Xasin/TapBadgeV2/KiCAD/ModelRef.jpg

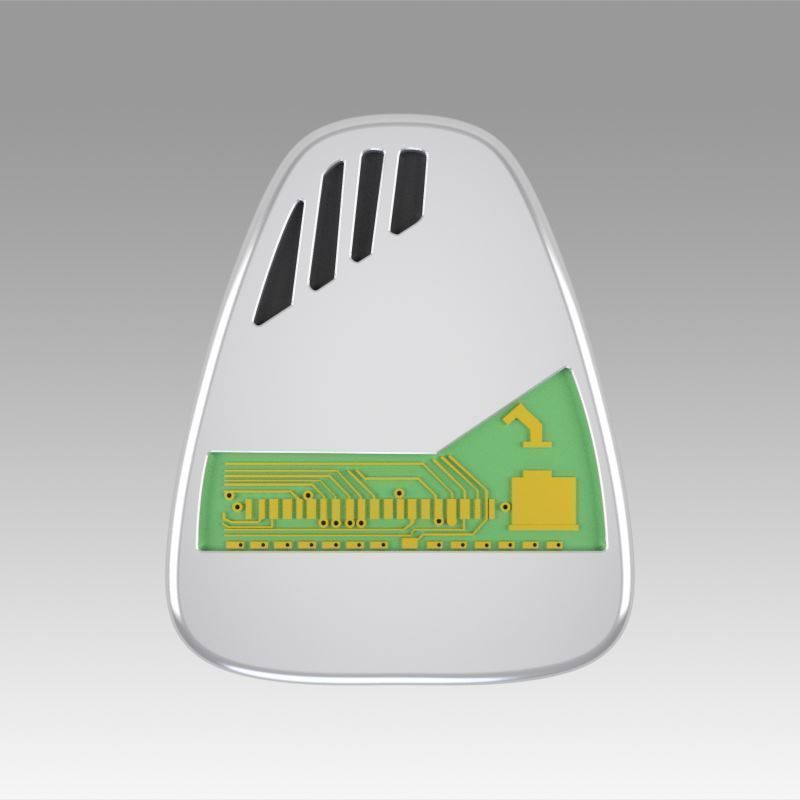
KiCAD/ModelRef.jpg
