Xasin/TapBadgeV2/README.md

# TapBadgeV2
The second, far more ambitious version of the TapBadge wearable
