Xasin/TapBadgeV2/KiCAD/LSM6DSMTR--3DModel-STEP-56544.STEP

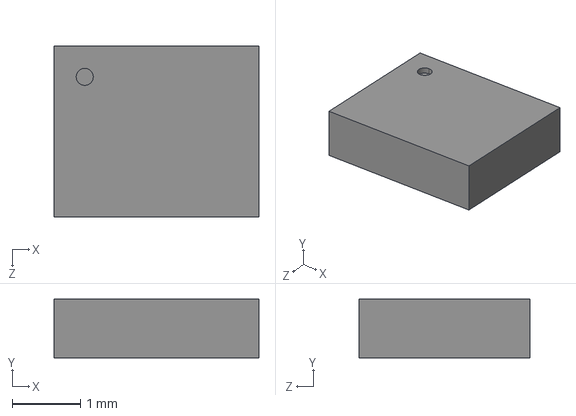
[picture p2: CAD file, 2021-07-29]
KiCAD/LSM6DSMTR--3DModel-STEP-56544.STEP
3.00 x 0.86 x 2.50 mm
