Xasin/TapBadgeV2/KiCAD/TMP/TapBadgeV2-B.Cu.dxf

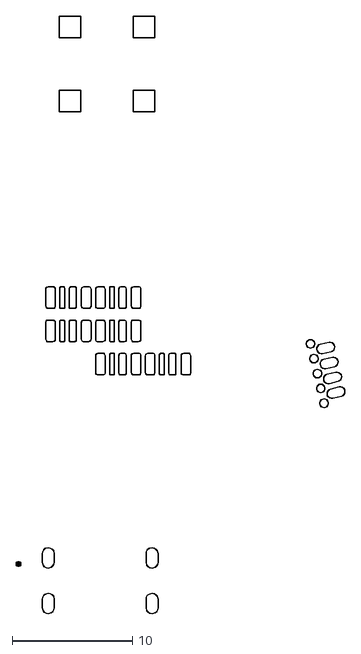
[picture p3: CAD file, 2021-07-29]
KiCAD/TMP/TapBadgeV2-B.Cu.dxf
27.4 x 49.8
