Xasin/TapBadgeV2/KiCAD/TapRef.FCStd

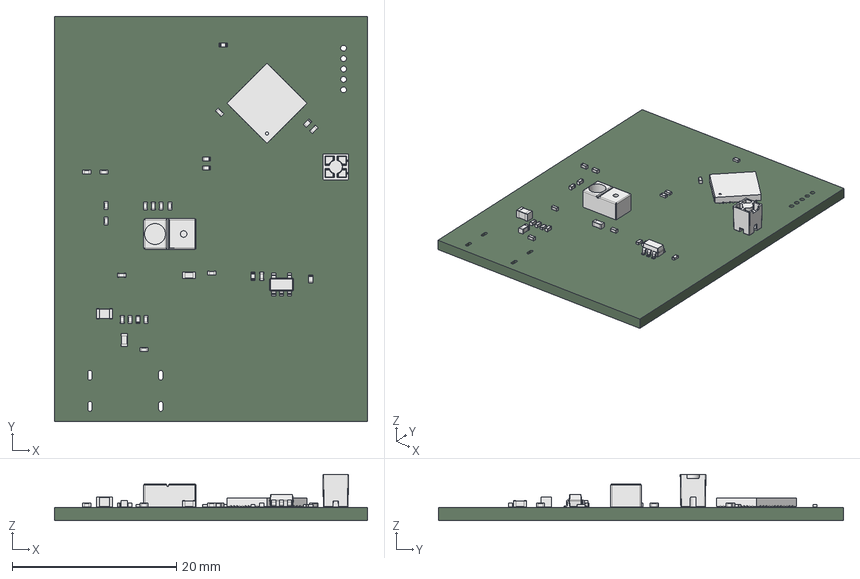
[picture p4: CAD file, 2021-07-29]
KiCAD/TapRef.FCStd
38.2 x 49.4 x 5.65 mm
