Xasin/TapBadgeV2/KiCAD/TMP/TapBadgeV2-Edge.Cuts.dxf

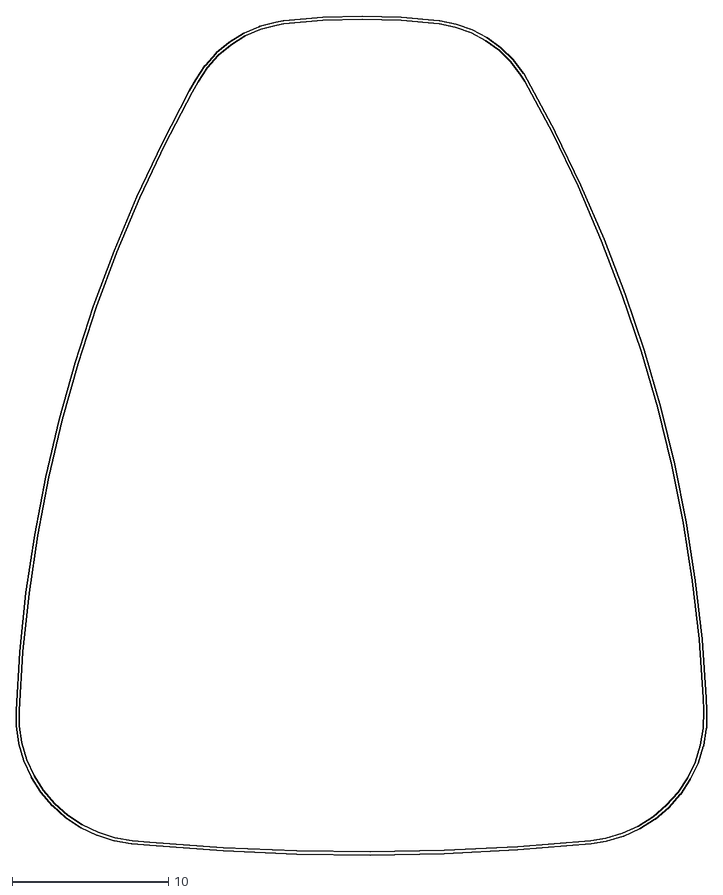
[picture p5: CAD file, 2021-07-29]
KiCAD/TMP/TapBadgeV2-Edge.Cuts.dxf
44.2 x 53.7
