Xasin/TapBadgeV2/KiCAD/TMP/TapBadgeV2-In1.Cu.dxf

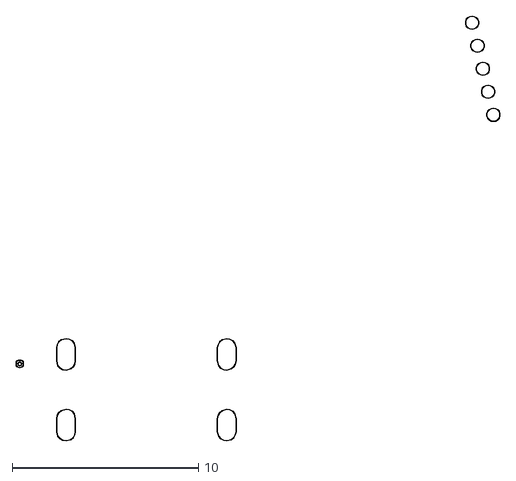
[picture p6: CAD file, 2021-07-29]
KiCAD/TMP/TapBadgeV2-In1.Cu.dxf
26.0 x 22.8
