Xasin/TapBadgeV2/KiCAD/TMP/TapBadgeV2-F.Cu.dxf

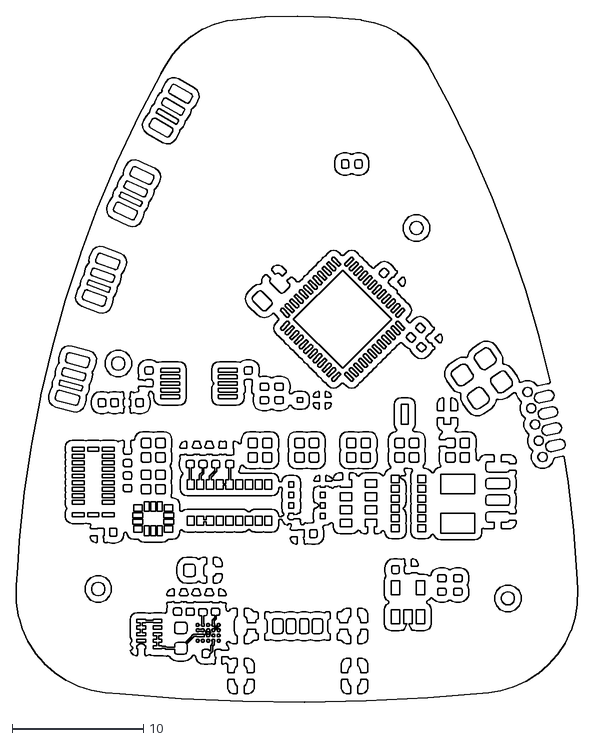
[picture p7: CAD file, 2021-07-29]
KiCAD/TMP/TapBadgeV2-F.Cu.dxf
42.8 x 52.2
