Xasin/TapBadgeV2/(list of files, cad)

Other CAD files:
KiCAD/TMP/TapBadgeV2-B.Mask.dxf
KiCAD/TMP/TapBadgeV2-B.Paste.dxf
KiCAD/TMP/TapBadgeV2-B.SilkS.dxf
KiCAD/TMP/TapBadgeV2-F.Mask.dxf
KiCAD/TMP/TapBadgeV2-F.Paste.dxf
KiCAD/TMP/TapBadgeV2-F.SilkS.dxf
KiCAD/TapRef.dxf
