Xasin/TapBadgeV2/KiCAD/TapBadgeV2.kicad_pcb

## KiCad design KiCAD/TapBadgeV2.kicad_pcb (2021-10-18)

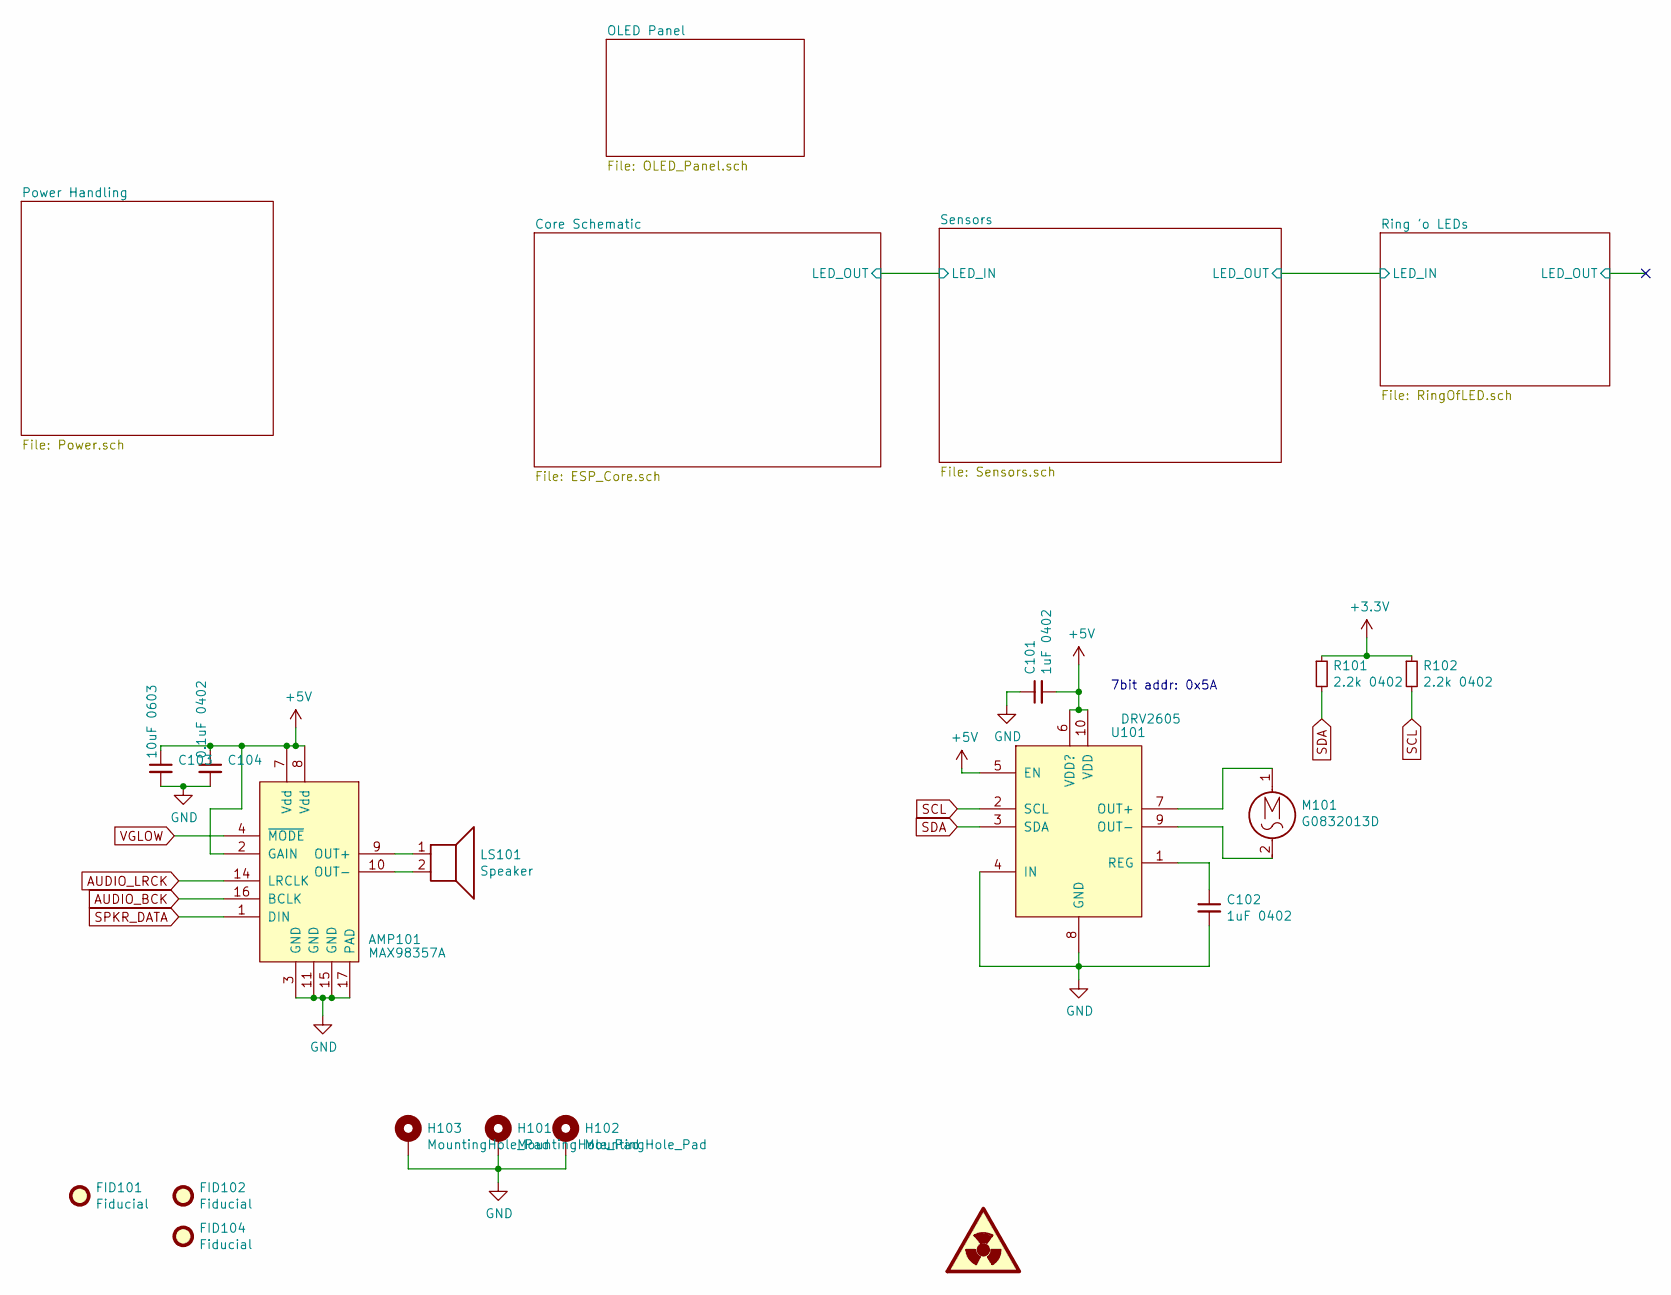
[picture p8: schematic TapBadgeV2.sch]

Parts:
AMP101: MAX98357A; QFN-16-1EP_3x3mm_P0.5mm_EP1.9x1.9mm_ThermalVias
C101, C102: 1uF 0402; C_0402_1005Metric
C103: 10uF 0603; C_0603_1608Metric
C104: 0.1uF 0402; C_0402_1005Metric
FID101, FID102, FID104: Fiducial; Fiducial_1mm_Mask2mm
H101, H102, H103: MountingHole_Pad; MountingHole_1.5mm_M1_Pad_Via
LS101: Speaker; SP-1609S-1
M101: G0832013D; PinHeader_1x02_P2.00mm_Vertical
R101, R102: 2.2k 0402; R_0402_1005Metric
SYM101: SYM_Radioactive_Large; DragonIcon_7mm_Solder
U101: DRV2605; VSSOP-10_3x3mm_P0.5mm

Connections:
+3V3: R101.1, R102.1; also elsewhere on the board
+5V: AMP101.2 (GAIN), AMP101.7 (Vdd), AMP101.8 (Vdd), C101.2, C103.1, C104.1, U101.5 (EN), U101.6 (VDD?), U101.10 (VDD); also elsewhere on the board
AUDIO_BCK: AMP101.16 (BCLK); also elsewhere on the board
AUDIO_LRCK: AMP101.14 (LRCLK); also elsewhere on the board
GND: AMP101.3 (GND), AMP101.11 (GND), AMP101.15 (GND), AMP101.17 (PAD), C101.1, C102.2, C103.2, C104.2, H101.1, H102.1, H103.1, U101.4 (IN), U101.8 (GND); also elsewhere on the board
unnamed: AMP101.9 (OUT+), LS101.1
unnamed: AMP101.10 (OUT-), LS101.2
unnamed: C102.1, U101.1 (REG)
unnamed: M101.1, U101.7 (OUT+)
unnamed: M101.2, U101.9 (OUT-)
SCL: R102.2, U101.2 (SCL); also elsewhere on the board
SDA: R101.2, U101.3 (SDA); also elsewhere on the board
SPKR_DATA: AMP101.1 (DIN); also elsewhere on the board
VGLOW: AMP101.4 (~MODE); also elsewhere on the board

Notes on the sheet:
7bit addr: 0x5A

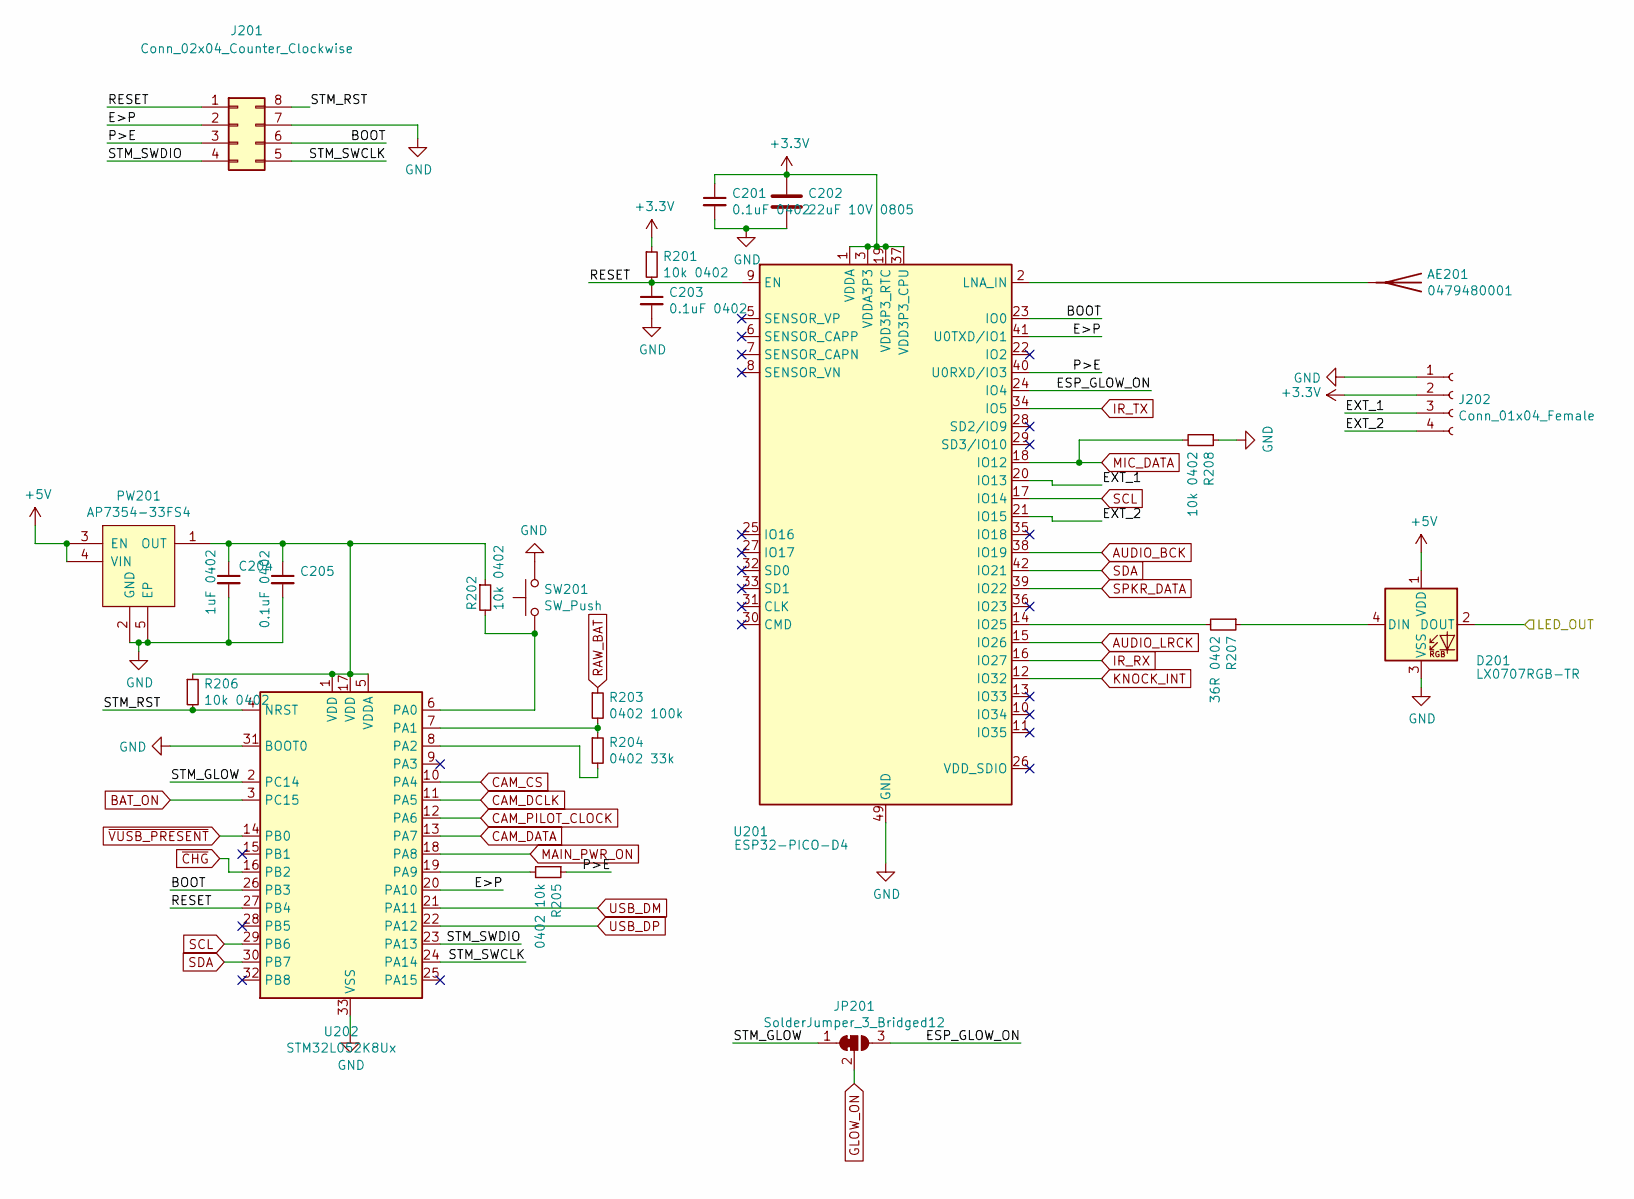
[picture p9: schematic ESP_Core.sch]

Parts:
AE201: 0479480001
C201, C203, C205: 0.1uF 0402; C_0402_1005Metric
C202: 22uF 10V 0805; C_0805_2012Metric
C204: 1uF 0402; C_0402_1005Metric
D201: LX0707RGB-TR; SMD-LX0707RGB-TR
J201: Conn_02x04_Counter_Clockwise; SOIC_clipProgSmall
J202: Conn_01x04_Female; PinHeader_1x04_P1.27mm_Vertical
JP201: SolderJumper_3_Bridged12; SolderJumper-3_P1.3mm_Open_RoundedPad1.0x1.5mm
PW201: AP7354-33FS4; X2-DFN1010-4
R201, R202, R206, R208: 10k 0402; R_0402_1005Metric
R203: 0402 100k; R_0402_1005Metric
R204: 0402 33k; R_0402_1005Metric
R205: 0402 10k; R_0402_1005Metric
R207: 36R 0402; R_0402_1005Metric
SW201: SW_Push; SW_SPST_B3U-1000P
U201: ESP32-PICO-D4; QFN-48-1EP_7x7mm_P0.5mm_EP5.3x5.3mm
U202: STM32L052K8Ux; QFN-32-1EP_5x5mm_P0.5mm_EP3.45x3.45mm

Connections:
+3V3: C201.1, C202.1, J202.2, R201.1, U201.1 (VDDA), U201.3 (VDDA3P3), U201.4 (VDDA3P3), U201.19 (VDD3P3_RTC), U201.37 (VDD3P3_CPU), U201.43 (VDDA), U201.46 (VDDA); also elsewhere on the board
+5V: D201.1 (VDD), PW201.3 (EN), PW201.4 (VIN); also elsewhere on the board
/Core Schematic/BOOT: J201.6, U201.23 (IO0), U202.26 (PB3)
/Core Schematic/E>P: J201.2, U201.41 (U0TXD/IO1), U202.20 (PA10)
/Core Schematic/ESP_GLOW_ON: JP201.3 (B), U201.24 (IO4)
/Core Schematic/EXT_1: J202.3, U201.20 (IO13)
/Core Schematic/EXT_2: J202.4, U201.21 (IO15)
/Core Schematic/P>E: J201.3, R205.1, U201.40 (U0RXD/IO3)
/Core Schematic/RESET: C203.1, J201.1, R201.2, U201.9 (EN), U202.27 (PB4)
/Core Schematic/STM_GLOW: JP201.1 (A), U202.2 (PC14)
/Core Schematic/STM_RST: J201.8, R206.2, U202.4 (NRST)
/Core Schematic/STM_SWCLK: J201.5, U202.24 (PA14)
/Core Schematic/STM_SWDIO: J201.4, U202.23 (PA13)
/Sensors/LED_IN: D201.2 (DOUT); also elsewhere on the board
AUDIO_BCK: U201.38 (IO19); also elsewhere on the board
AUDIO_LRCK: U201.15 (IO26); also elsewhere on the board
BAT_ON: U202.3 (PC15); also elsewhere on the board
CAM_CS: U202.10 (PA4); also elsewhere on the board
CAM_DATA: U202.13 (PA7); also elsewhere on the board
CAM_DCLK: U202.11 (PA5); also elsewhere on the board
CAM_PILOT_CLOCK: U202.12 (PA6); also elsewhere on the board
GLOW_ON: JP201.2 (C); also elsewhere on the board
GND: C201.2, C202.2, C203.2, C204.2, C205.2, D201.3 (VSS), J201.7, J202.1, PW201.2 (GND), PW201.5 (EP), R208.1, SW201.2, U201.49 (GND), U202.31 (BOOT0), U202.33 (VSS); also elsewhere on the board
IR_RX: U201.16 (IO27); also elsewhere on the board
IR_TX: U201.34 (IO5); also elsewhere on the board
KNOCK_INT: U201.12 (IO32); also elsewhere on the board
MAIN_PWR_ON: U202.18 (PA8); also elsewhere on the board
MIC_DATA: R208.2, U201.18 (IO12); also elsewhere on the board
unnamed: AE201.1, U201.2 (LNA_IN)
unnamed: C204.1, C205.1, PW201.1 (OUT), R202.1, R206.1, U202.1 (VDD), U202.5 (VDDA), U202.17 (VDD)
unnamed: D201.4 (DIN), R207.1
unnamed: R202.2, SW201.1, U202.6 (PA0)
unnamed: R203.2, R204.1, U202.7 (PA1)
unnamed: R204.2, U202.8 (PA2)
unnamed: R205.2, U202.19 (PA9)
unnamed: R207.2, U201.14 (IO25)
RAW_BAT: R203.1; also elsewhere on the board
SCL: U201.17 (IO14), U202.29 (PB6); also elsewhere on the board
SDA: U201.42 (IO21), U202.30 (PB7); also elsewhere on the board
SPKR_DATA: U201.39 (IO22); also elsewhere on the board
USB_DM: U202.21 (PA11); also elsewhere on the board
USB_DP: U202.22 (PA12); also elsewhere on the board
~CHG: U202.16 (PB2); also elsewhere on the board
~VUSB_PRESENT: U202.14 (PB0); also elsewhere on the board

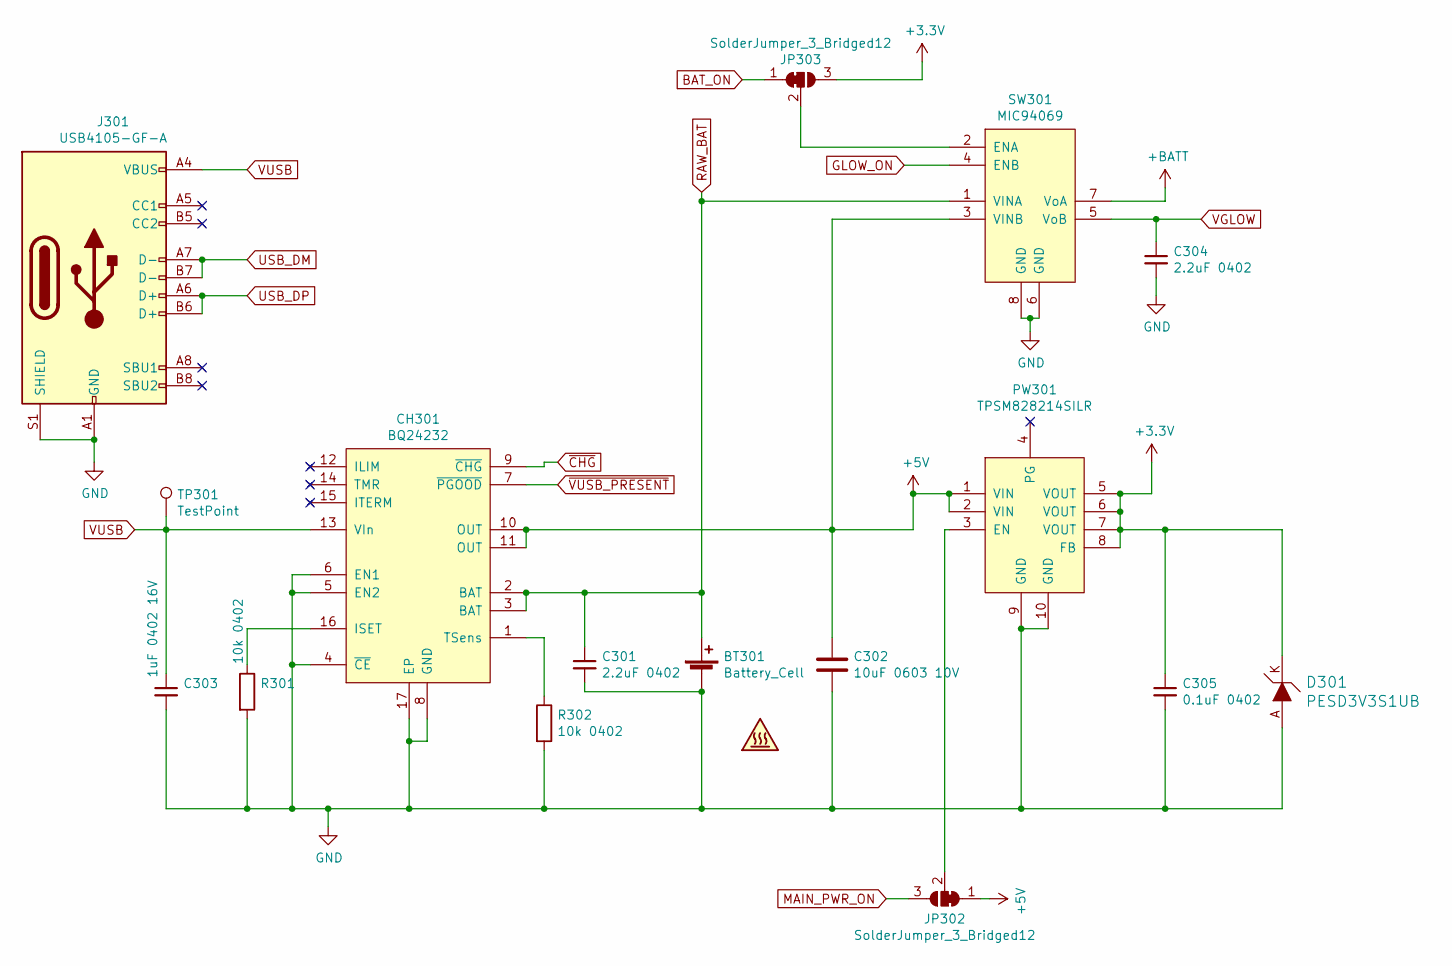
[picture p10: schematic Power.sch]

Parts:
BAT301: SYM_Hot_Small; LiPo_150mAh
BT301: Battery_Cell; JST_PH_S2B-PH-SM4-TB_1x02-1MP_P2.00mm_Horizontal
C301, C304: 2.2uF 0402; C_0402_1005Metric
C302: 10uF 0603 10V; C_0603_1608Metric
C303: 1uF 0402 16V; C_0402_1005Metric
C305: 0.1uF 0402; C_0402_1005Metric
CH301: BQ24232; VQFN-16-1EP_3x3mm_P0.5mm_EP1.6x1.6mm_ThermalVias
D301: PESD3V3S1UB; SOD-523; MPN ESD5Z3.3T1G; Digi-Key_PN ESD5Z3.3T1GOSCT-ND
J301: USB4105-GF-A; USB_C_Receptacle_HRO_TYPE-C-31-M-12
JP302, JP303: SolderJumper_3_Bridged12; SolderJumper-3_P1.3mm_Open_RoundedPad1.0x1.5mm
PW301: TPSM828214SILR; uSIP-10
R301, R302: 10k 0402; R_0402_1005Metric
SW301: MIC94069; MLF-6-EP-P0.5mm
TP301: TestPoint; PinHeader_1x01_P1.27mm_Vertical

Connections:
+3V3: C305.1, D301.K, JP303.3 (B), PW301.5 (VOUT), PW301.6 (VOUT), PW301.7 (VOUT), PW301.8 (FB); also elsewhere on the board
+5V: C302.1, CH301.10 (OUT), CH301.11 (OUT), JP302.1 (A), PW301.1 (VIN), PW301.2 (VIN), SW301.3 (VINB); also elsewhere on the board
+BATT: SW301.7 (VoA); also elsewhere on the board
BAT_ON: JP303.1 (A); also elsewhere on the board
GLOW_ON: SW301.4 (ENB); also elsewhere on the board
GND: BT301.2 (-), C301.2, C302.2, C303.2, C304.2, C305.2, CH301.4 (~CE), CH301.5 (EN2), CH301.6 (EN1), CH301.8 (GND), CH301.17 (EP), D301.A, J301.A1 (GND), J301.A12 (GND), J301.B1 (GND), J301.B12 (GND), J301.S1 (SHIELD), PW301.9 (GND), PW301.10 (GND), R301.2, R302.2, SW301.6 (GND), SW301.8 (GND); also elsewhere on the board
MAIN_PWR_ON: JP302.3 (B); also elsewhere on the board
unnamed: CH301.1 (TSens), R302.1
unnamed: CH301.16 (ISET), R301.1
unnamed: JP302.2 (C), PW301.3 (EN)
unnamed: JP303.2 (C), SW301.2 (ENA)
RAW_BAT: BT301.1 (+), C301.1, CH301.2 (BAT), CH301.3 (BAT), SW301.1 (VINA); also elsewhere on the board
USB_DM: J301.A7 (D-), J301.B7 (D-); also elsewhere on the board
USB_DP: J301.A6 (D+), J301.B6 (D+); also elsewhere on the board
VGLOW: C304.1, SW301.5 (VoB); also elsewhere on the board
VUSB: C303.1, CH301.13 (VIn), J301.A4 (VBUS), J301.A9 (VBUS), J301.B4 (VBUS), J301.B9 (VBUS), TP301.1
~CHG: CH301.9 (~CHG); also elsewhere on the board
~VUSB_PRESENT: CH301.7 (~PGOOD); also elsewhere on the board

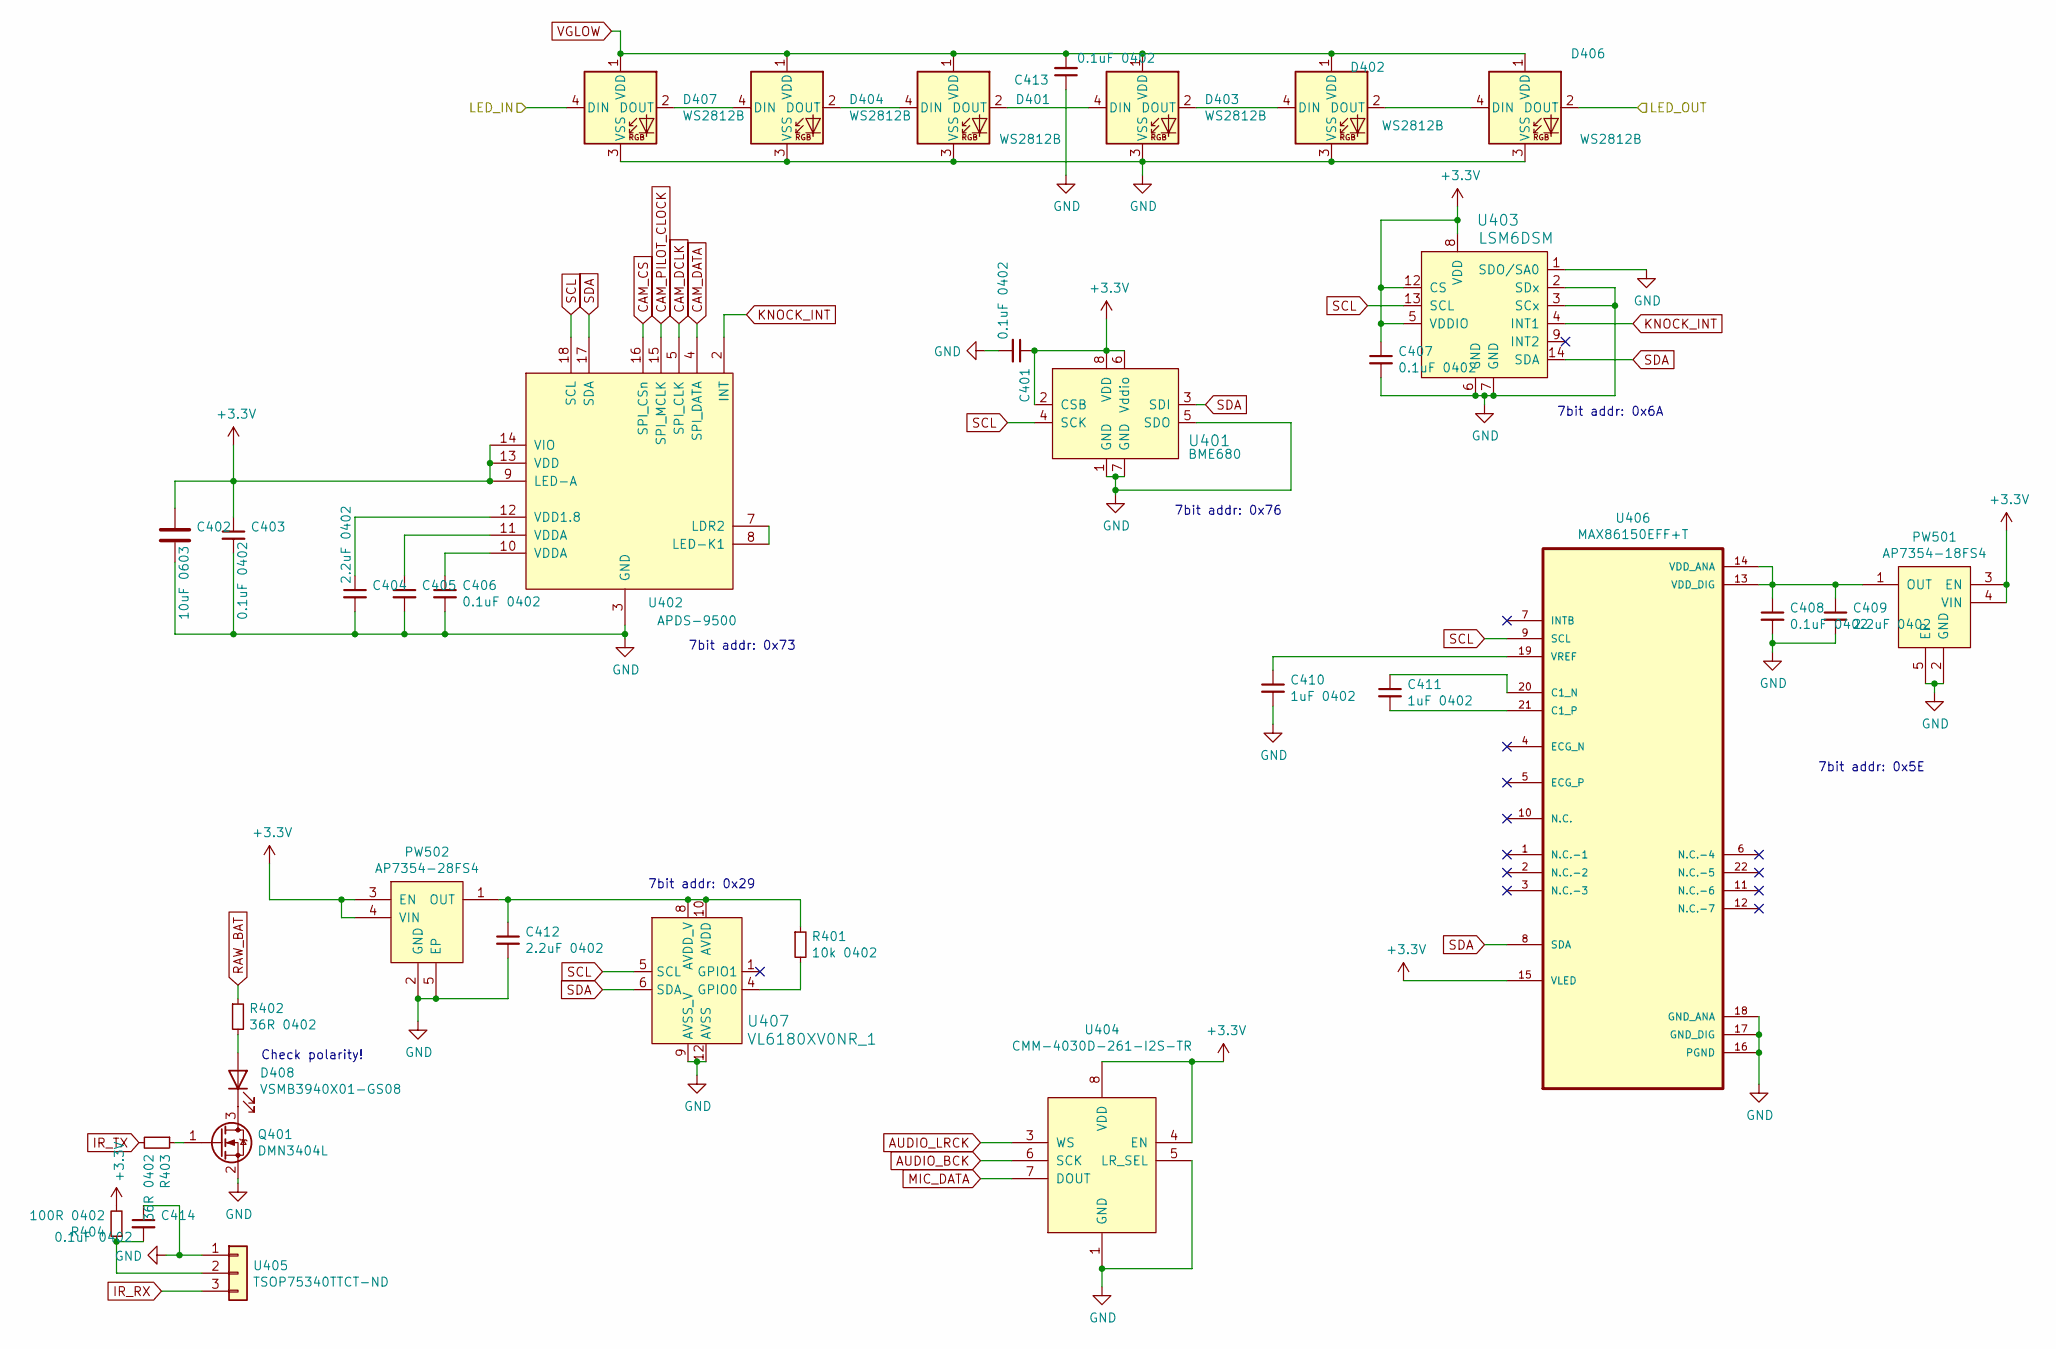
[picture p11: schematic Sensors.sch]

Parts:
C401, C403, C405, C406, C407, C408, C413, C414: 0.1uF 0402; C_0402_1005Metric
C402: 10uF 0603; C_0603_1608Metric
C404, C409, C412: 2.2uF 0402; C_0402_1005Metric
C410, C411: 1uF 0402; C_0402_1005Metric
D401, D402, D403, D404, D406, D407: WS2812B; SMD-LX0707RGB-TR
D408: VSMB3940X01-GS08; LED_PLCC-2
PW501: AP7354-18FS4; X2-DFN1010-4
PW502: AP7354-28FS4; X2-DFN1010-4
Q401: DMN3404L; SOT-23
R401: 10k 0402; R_0402_1005Metric
R402, R403: 36R 0402; R_0402_1005Metric
R404: 100R 0402; R_0402_1005Metric
U401: BME680; MPN BME680; Digi-Key_PN 828-1077-1-ND
U402: APDS-9500
U403: LSM6DSM; LGA-14L_2.5x3mm__LSM6DS3; MPN LSM6DS3TR; Digi-Key_PN 497-15383-1-ND
U404: CMM-4030D-261-I2S-TR; CMM-4030
U405: TSOP75340TTCT-ND; TSOP75xxx
U406: MAX86150EFF+T; XDCR_MAX86150EFF+
U407: VL6180XV0NR_1; LGA-12_4.8x2.8_VL6180; MPN VL6180XV0NR/1; Digi-Key_PN 497-14702-1-ND

Connections:
+3V3: C401.1, C402.1, C403.1, C407.1, PW501.3 (EN), PW501.4 (VIN), PW502.3 (EN), PW502.4 (VIN), R404.2, U401.2 (CSB), U401.6 (Vddio), U401.8 (VDD), U402.9 (LED-A), U402.13 (VDD), U402.14 (VIO), U403.5 (VDDIO), U403.8 (VDD), U403.12 (CS), U404.4 (EN), U404.8 (VDD), U406.15 (VLED); also elsewhere on the board
/Ring 'o LEDs/LED_IN: D406.2 (DOUT); also elsewhere on the board
/Sensors/LED_IN: D407.4 (DIN); also elsewhere on the board
AUDIO_BCK: U404.6 (SCK); also elsewhere on the board
AUDIO_LRCK: U404.3 (WS); also elsewhere on the board
CAM_CS: U402.16 (SPI_CSn); also elsewhere on the board
CAM_DATA: U402.4 (SPI_DATA); also elsewhere on the board
CAM_DCLK: U402.5 (SPI_CLK); also elsewhere on the board
CAM_PILOT_CLOCK: U402.15 (SPI_MCLK); also elsewhere on the board
GND: C401.2, C402.2, C403.2, C404.2, C405.2, C406.2, C407.2, C408.2, C409.2, C410.2, C412.2, C413.1, C414.1, D401.3 (VSS), D402.3 (VSS), D403.3 (VSS), D404.3 (VSS), D406.3 (VSS), D407.3 (VSS), PW501.2 (GND), PW501.5 (EP), PW502.2 (GND), PW502.5 (EP), Q401.2 (S), U401.1 (GND), U401.5 (SDO), U401.7 (GND), U402.3 (GND), U403.1 (SDO/SA0), U403.2 (SDx), U403.3 (SCx), U403.6 (GND), U403.7 (GND), U404.1 (GND), U404.5 (LR_SEL), U405.1, U406.16 (PGND), U406.17 (GND_DIG), U406.18 (GND_ANA), U407.9 (AVSS_V), U407.12 (AVSS); also elsewhere on the board
IR_RX: U405.3; also elsewhere on the board
IR_TX: R403.2; also elsewhere on the board
KNOCK_INT: U402.2 (INT), U403.4 (INT1); also elsewhere on the board
MIC_DATA: U404.7 (DOUT); also elsewhere on the board
unnamed: C404.1, U402.12 (VDD1.8)
unnamed: C405.1, U402.11 (VDDA)
unnamed: C406.1, U402.10 (VDDA)
unnamed: C408.1, C409.1, PW501.1 (OUT), U406.13 (VDD_DIG), U406.14 (VDD_ANA)
unnamed: C410.1, U406.19 (VREF)
unnamed: C411.1, U406.20 (C1_N)
unnamed: C411.2, U406.21 (C1_P)
unnamed: C412.1, PW502.1 (OUT), R401.1, U407.8 (AVDD_V), U407.10 (AVDD)
unnamed: C414.2, R404.1, U405.2
unnamed: D401.2 (DOUT), D403.4 (DIN)
unnamed: D401.4 (DIN), D404.2 (DOUT)
unnamed: D402.2 (DOUT), D406.4 (DIN)
unnamed: D402.4 (DIN), D403.2 (DOUT)
unnamed: D404.4 (DIN), D407.2 (DOUT)
unnamed: D408.1 (K), Q401.3 (D)
unnamed: D408.2 (A), R402.2
unnamed: Q401.1 (G), R403.1
unnamed: R401.2, U407.4 (GPIO0)
unnamed: U402.7 (LDR2), U402.8 (LED-K1)
RAW_BAT: R402.1; also elsewhere on the board
SCL: U401.4 (SCK), U402.18 (SCL), U403.13 (SCL), U406.9 (SCL), U407.5 (SCL); also elsewhere on the board
SDA: U401.3 (SDI), U402.17 (SDA), U403.14 (SDA), U406.8 (SDA), U407.6 (SDA); also elsewhere on the board
VGLOW: C413.2, D401.1 (VDD), D402.1 (VDD), D403.1 (VDD), D404.1 (VDD), D406.1 (VDD), D407.1 (VDD); also elsewhere on the board

Notes on the sheet:
Check polarity!
7bit addr: 0x76
7bit addr: 0x6A
7bit addr: 0x73
7bit addr: 0x29
7bit addr: 0x5E

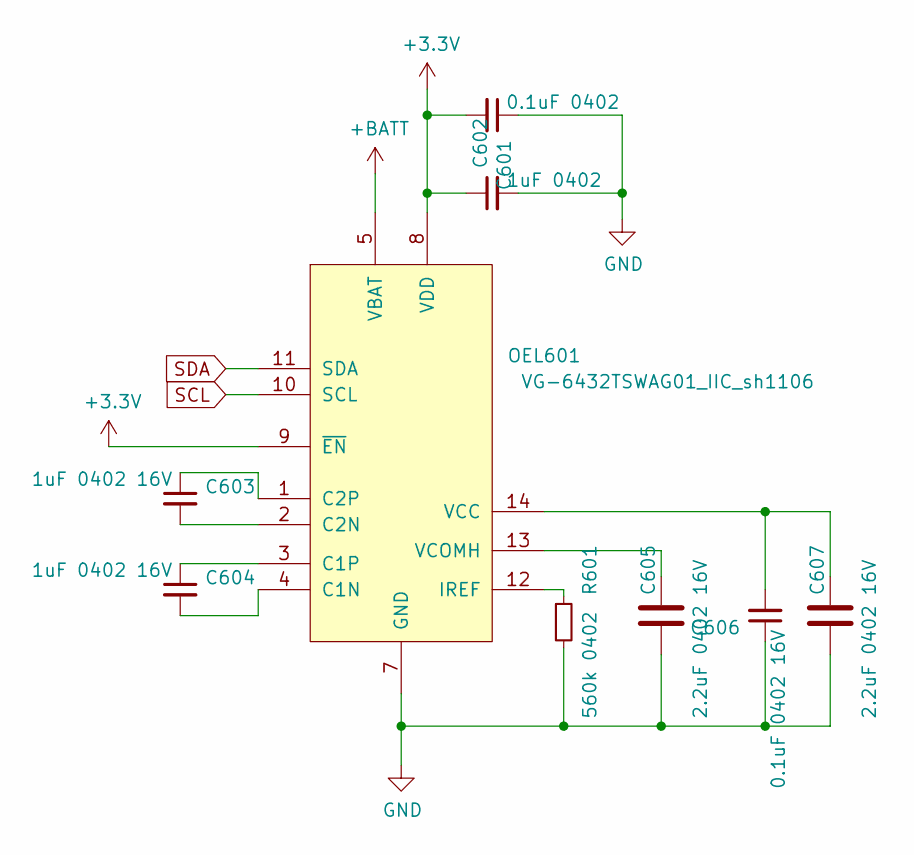
[picture p12: schematic OLED_Panel.sch]

Parts:
C601: 0.1uF 0402; C_0402_1005Metric
C602: 1uF 0402; C_0402_1005Metric
C603, C604: 1uF 0402 16V; C_0402_1005Metric
C605, C607: 2.2uF 0402 16V; C_0402_1005Metric
C606: 0.1uF 0402 16V; C_0402_1005Metric
OEL601: VG-6432TSWAG01_IIC_sh1106; OLED_Smoll_Upsidedown
R601: 560k 0402; R_0402_1005Metric

Connections:
+3V3: C601.2, C602.1, OEL601.8 (VDD), OEL601.9 (~EN); also elsewhere on the board
+BATT: OEL601.5 (VBAT); also elsewhere on the board
GND: C601.1, C602.2, C605.2, C606.1, C607.2, OEL601.7 (GND), R601.2; also elsewhere on the board
unnamed: C603.1, OEL601.1 (C2P)
unnamed: C603.2, OEL601.2 (C2N)
unnamed: C604.1, OEL601.3 (C1P)
unnamed: C604.2, OEL601.4 (C1N)
unnamed: C605.1, OEL601.13 (VCOMH)
unnamed: C606.2, C607.1, OEL601.14 (VCC)
unnamed: OEL601.12 (IREF), R601.1
SCL: OEL601.10 (SCL); also elsewhere on the board
SDA: OEL601.11 (SDA); also elsewhere on the board

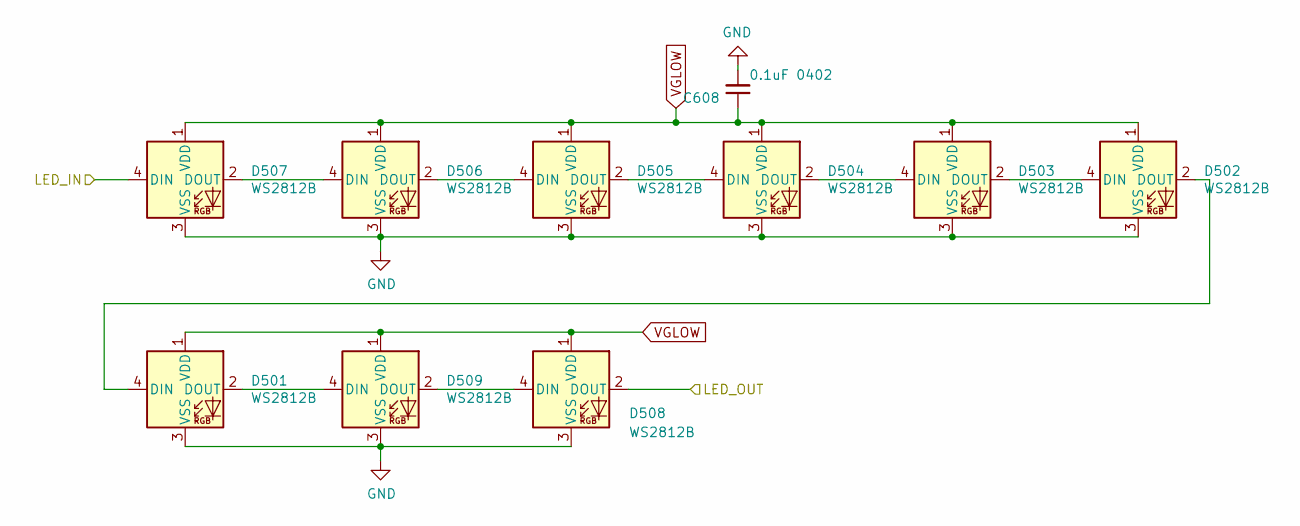
[picture p13: schematic RingOfLED.sch]

Parts:
C608: 0.1uF 0402; C_0402_1005Metric
D501, D502, D503, D504, D505, D506, D507, D508, D509: WS2812B; IN-PI42TAS

Connections:
/Ring 'o LEDs/LED_IN: D507.4 (DIN); also elsewhere on the board
/Ring 'o LEDs/LED_OUT: D508.2 (DOUT)
GND: C608.2, D501.3 (VSS), D502.3 (VSS), D503.3 (VSS), D504.3 (VSS), D505.3 (VSS), D506.3 (VSS), D507.3 (VSS), D508.3 (VSS), D509.3 (VSS); also elsewhere on the board
unnamed: D501.2 (DOUT), D509.4 (DIN)
unnamed: D501.4 (DIN), D502.2 (DOUT)
unnamed: D502.4 (DIN), D503.2 (DOUT)
unnamed: D503.4 (DIN), D504.2 (DOUT)
unnamed: D504.4 (DIN), D505.2 (DOUT)
unnamed: D505.4 (DIN), D506.2 (DOUT)
unnamed: D506.4 (DIN), D507.2 (DOUT)
unnamed: D508.4 (DIN), D509.2 (DOUT)
VGLOW: C608.1, D501.1 (VDD), D502.1 (VDD), D503.1 (VDD), D504.1 (VDD), D505.1 (VDD), D506.1 (VDD), D507.1 (VDD), D508.1 (VDD), D509.1 (VDD); also elsewhere on the board

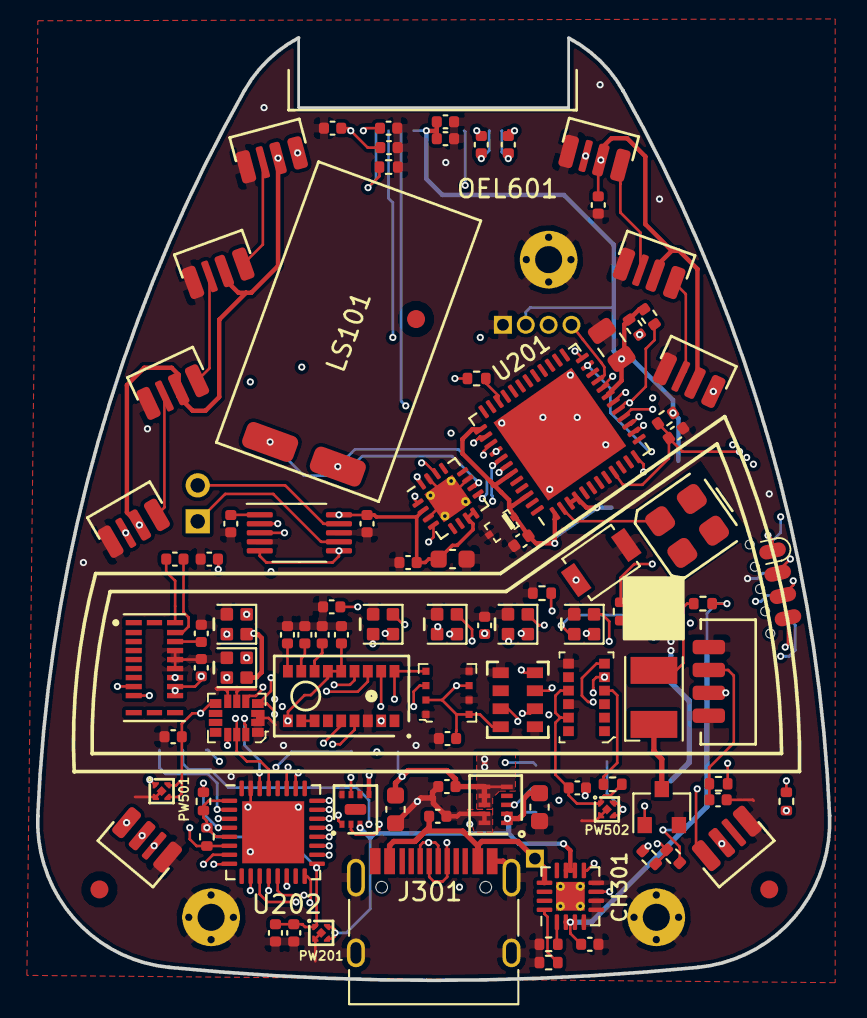
[picture p14: board TapBadgeV2.kicad_pcb from above]

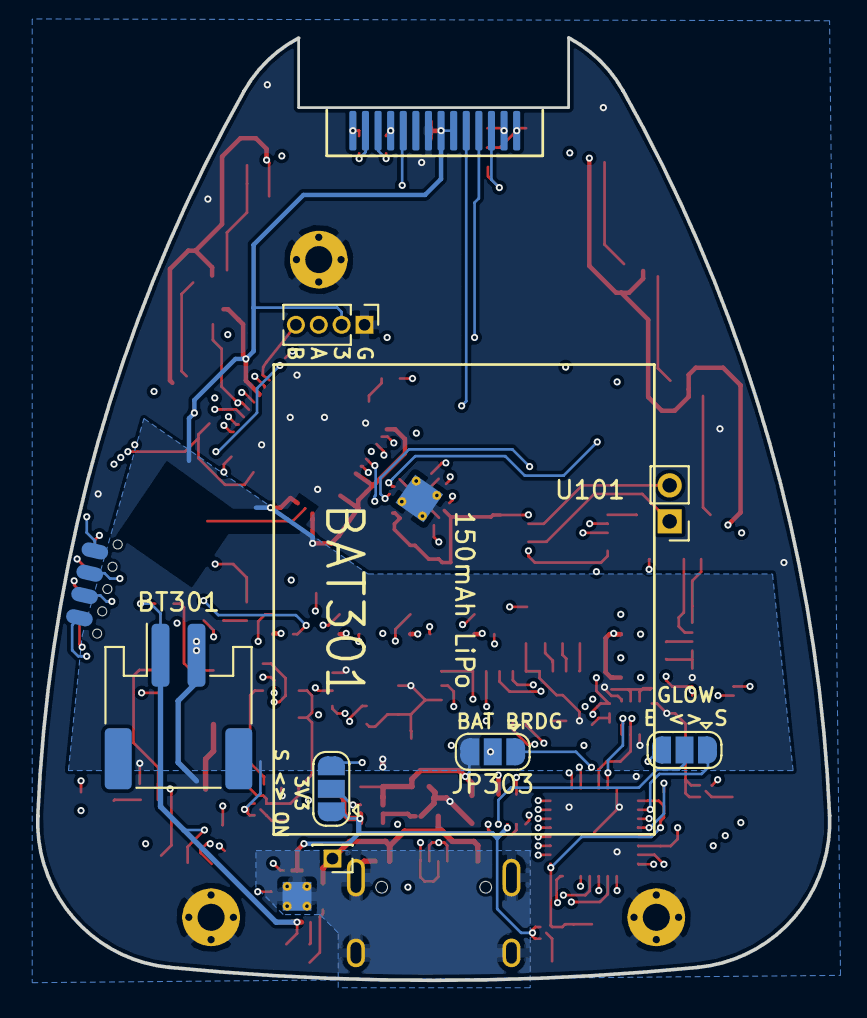
[picture p15: board TapBadgeV2.kicad_pcb from below]

Board: 4 copper layers, 44.0 x 52.4 mm, 110 parts (9 on the bottom side), 91 nets.
