Xasin/TapBadgeV2/STM32/Coprocessor/Coprocessor.ioc

Mcu.UserName=STM32L051K8Ux
PA0.Signal=SYS_WKUP1
PA1.Signal=ADC_IN1
PA13.Signal=SYS_SWDIO
PA14.Signal=SYS_SWCLK
PA4.Signal=SPI1_NSS
PA5.Signal=SPI1_SCK
PA6.Signal=SPI1_MISO
PA9.Signal=USART1_TX
PB6.Signal=I2C1_SCL
PB7.Signal=I2C1_SDA
