Xasin/TapBadgeV2/ESP32/main/click_2.h

#include <xasin/audio.h>

const uint8_t raw_audio_array_click_2[] = {
		125, 129, 130, 127, 126, 127, 126, 127, 130, 
		130, 125, 125, 129, 128, 125, 125, 127, 128, 
		127, 127, 128, 126, 125, 126, 128, 129, 126, 
		125, 127, 127, 125, 125, 129, 127, 125, 127, 
		130, 129, 124, 125, 128, 128, 126, 127, 128, 
		126, 127, 130, 126, 123, 125, 128, 128, 127, 
		127, 126, 125, 126, 130, 128, 125, 124, 128, 
		130, 127, 126, 127, 127, 126, 129, 132, 125, 
		122, 127, 130, 125, 125, 131, 131, 125, 126, 
		130, 124, 121, 129, 134, 128, 125, 127, 126, 
		124, 127, 129, 127, 125, 127, 130, 127, 124, 
		124, 125, 131, 134, 131, 120, 121, 130, 124, 
		127, 136, 128, 120, 125, 143, 129, 109, 121, 
		136, 123, 129, 134, 158, 112, 82, 135, 143, 
		135, 104, 140, 161, 128, 93, 114, 140, 144, 
		98, 138, 115, 148, 152, 127, 116, 60, 171, 
		157, 82, 94, 178, 200, 126, 41, 101, 120, 
		207, 120, 72, 109, 170, 220, 86, 63, 75, 
		178, 169, 142, 57, 106, 188, 188, 92, 55, 
		101, 165, 184, 111, 104, 114, 159, 128, 122, 
		104, 127, 117, 154, 170, 86, 97, 137, 147, 
		129, 132, 130, 96, 128, 145, 147, 107, 106, 
		155, 128, 113, 114, 145, 135, 115, 110, 149, 
		150, 101, 102, 141, 172, 116, 91, 112, 151, 
		153, 138, 113, 88, 136, 152, 140, 102, 117, 
		136, 138, 131, 117, 122, 131, 137, 118, 125, 
		130, 118, 126, 139, 133, 112, 119, 137, 131, 
		124, 124, 138, 111, 119, 133, 147, 135, 112, 
		120, 122, 144, 129, 109, 114, 133, 144, 141, 
		121, 116, 113, 135, 131, 122, 126, 122, 146, 
		132, 121, 113, 118, 141, 135, 126, 120, 121, 
		135, 134, 122, 116, 123, 140, 126, 121, 126, 
		129, 135, 115, 126, 127, 132, 133, 120, 123, 
		129, 139, 126, 118, 129, 125, 125, 136, 134, 
		123, 116, 128, 139, 128, 121, 118, 132, 138, 
		125, 123, 119, 133, 132, 126, 126, 125, 129, 
		128, 127, 131, 122, 123, 132, 130, 130, 123, 
		125, 128, 127, 126, 123, 131, 128, 124, 129, 
		132, 126, 115, 127, 134, 127, 125, 125, 132, 
		132, 125, 126, 124, 127, 131, 129, 127, 124, 
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
};

const Xasin::Audio::bytecassette_data_t cassette_click_2 = XASAUDIO_CASSETTE(raw_audio_array_click_2, 24000, 20);
