Xasin/TapBadgeV2/ESP32/main/click_a.h

#include <xasin/audio.h>

static const uint8_t raw_audio_array_click_a[] = {

		128, 127, 126, 127, 127, 127, 128, 127, 126, 
		126, 126, 126, 129, 129, 126, 128, 130, 126, 
		124, 126, 126, 127, 129, 125, 125, 130, 128, 
		124, 126, 127, 123, 126, 131, 130, 125, 119, 
		122, 129, 130, 130, 131, 129, 131, 134, 128, 
		121, 122, 126, 127, 126, 124, 121, 118, 117, 
		124, 132, 132, 124, 127, 137, 133, 113, 102, 
		119, 139, 153, 153, 129, 108, 110, 115, 128, 
		156, 150, 93, 72, 142, 206, 180, 140, 132, 
		85, 53, 101, 109, 53, 88, 208, 251, 181, 
		90, 74, 124, 161, 148, 118, 111, 142, 154, 
		110, 76, 84, 105, 136, 148, 115, 98, 140, 
		186, 171, 126, 114, 116, 110, 133, 154, 143, 
		149, 141, 87, 67, 91, 110, 117, 122, 148, 
		188, 185, 154, 124, 84, 73, 101, 122, 141, 
		161, 155, 141, 128, 96, 73, 81, 124, 184, 
		195, 154, 126, 116, 102, 93, 97, 116, 139, 
		151, 161, 141, 90, 66, 92, 130, 159, 177, 
		185, 182, 155, 107, 63, 54, 89, 140, 171, 
		176, 160, 127, 96, 89, 105, 119, 139, 167, 
		166, 135, 119, 110, 94, 96, 123, 144, 141, 
		127, 123, 117, 108, 124, 152, 159, 159, 165, 
		160, 125, 74, 57, 99, 143, 148, 129, 114, 
		123, 145, 138, 109, 93, 102, 134, 172, 183, 
		169, 148, 118, 96, 86, 84, 104, 144, 173, 
		172, 132, 89, 75, 86, 118, 159, 180, 179, 
		159, 117, 83, 81, 92, 114, 142, 165, 175, 
		160, 117, 86, 88, 107, 132, 155, 158, 150, 
		135, 114, 103, 102, 116, 137, 150, 146, 136, 
		121, 111, 108, 116, 129, 139, 134, 131, 131, 
		134, 135, 129, 122, 116, 112, 116, 129, 142, 
		148, 147, 138, 128, 115, 96, 92, 110, 135, 
		148, 148, 137, 123, 115, 117, 127, 130, 134, 
		143, 150, 145, 126, 111, 112, 117, 124, 130, 
		128, 125, 126, 122, 122, 130, 131, 128, 121, 
		113, 117, 130, 141, 151, 150, 139, 127, 117, 
		109, 113, 118, 130, 143, 139, 126, 118, 113, 
		115, 126, 131, 131, 129, 123, 125, 127, 125, 
		128, 138, 144, 146, 139, 123, 110, 105, 111, 
		129, 141, 139, 132, 127, 121, 113, 109, 116, 
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
};
static const Xasin::Audio::bytecassette_data_t cassette_click_a = XASAUDIO_CASSETTE(raw_audio_array_click_a, 44100, 255);
