Xasin/TapBadgeV2/ESP32/main/click_b.h

#include <xasin/audio.h>

static const uint8_t raw_audio_array_click_b[] = {

		128, 127, 127, 127, 127, 127, 127, 127, 127, 
		127, 127, 127, 127, 127, 128, 126, 127, 127, 
		126, 127, 128, 127, 128, 126, 127, 127, 127, 
		127, 127, 127, 127, 127, 128, 127, 128, 127, 
		127, 128, 127, 126, 128, 128, 126, 127, 128, 
		127, 127, 127, 127, 127, 127, 127, 127, 128, 
		127, 126, 126, 127, 127, 126, 127, 128, 127, 
		127, 127, 128, 126, 127, 127, 127, 128, 128, 
		127, 126, 126, 127, 127, 127, 127, 127, 128, 
		127, 127, 127, 127, 127, 127, 127, 127, 127, 
		128, 128, 127, 127, 127, 127, 127, 127, 127, 
		128, 128, 126, 126, 126, 126, 127, 128, 128, 
		128, 128, 126, 126, 126, 127, 127, 128, 128, 
		128, 127, 127, 128, 127, 127, 127, 127, 127, 
		127, 127, 128, 127, 127, 127, 127, 127, 128, 
		128, 128, 127, 128, 128, 128, 127, 127, 127, 
		126, 126, 127, 128, 129, 127, 127, 126, 126, 
		127, 128, 128, 128, 128, 126, 126, 126, 127, 
		127, 128, 128, 128, 127, 127, 127, 128, 127, 
		128, 127, 126, 127, 127, 128, 127, 128, 127, 
		126, 126, 127, 127, 128, 127, 128, 128, 128, 
		126, 126, 126, 127, 128, 127, 128, 127, 127, 
		127, 128, 128, 128, 127, 127, 126, 127, 127, 
		128, 128, 129, 126, 126, 125, 127, 129, 129, 
		128, 127, 126, 127, 128, 127, 128, 126, 126, 
		126, 128, 128, 129, 127, 126, 125, 127, 128, 
		128, 129, 127, 126, 125, 125, 127, 129, 129, 
		128, 127, 127, 127, 128, 127, 128, 127, 125, 
		125, 125, 127, 127, 128, 128, 127, 127, 126, 
		126, 127, 128, 129, 128, 127, 125, 125, 126, 
		127, 128, 128, 126, 125, 125, 127, 129, 130, 
		129, 127, 126, 125, 125, 125, 126, 127, 127, 
		126, 126, 127, 128, 127, 127, 125, 125, 127, 
		128, 130, 129, 126, 123, 123, 124, 127, 129, 
		129, 129, 126, 127, 127, 128, 129, 127, 124, 
		123, 124, 126, 128, 131, 129, 128, 125, 125, 
		124, 126, 129, 129, 128, 127, 125, 125, 127, 
		128, 129, 127, 125, 124, 126, 131, 133, 132, 
		128, 122, 119, 122, 126, 130, 130, 127, 124, 
		122, 124, 130, 133, 132, 130, 123, 122, 124, 
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
};
static const Xasin::Audio::bytecassette_data_t cassette_click_b = XASAUDIO_CASSETTE(raw_audio_array_click_b, 44100, 255);
