Xasin/TapBadgeV2/ESP32/main/clickl_4.h

#include <xasin/audio.h>

const uint8_t raw_audio_array_clickl_4[] = {

		130, 125, 128, 127, 120, 124, 120, 132, 134, 
		118, 138, 136, 117, 124, 131, 129, 118, 110, 
		123, 151, 139, 123, 115, 126, 121, 133, 137, 
		122, 130, 105, 127, 144, 136, 121, 110, 137, 
		143, 123, 108, 109, 143, 151, 131, 125, 100, 
		117, 125, 165, 136, 108, 103, 110, 139, 139, 
		165, 128, 106, 115, 141, 117, 117, 113, 127, 
		130, 135, 138, 138, 139, 118, 140, 133, 95, 
		79, 84, 167, 214, 137, 76, 108, 169, 106, 
		144, 145, 89, 97, 126, 154, 157, 105, 71, 
		161, 191, 147, 95, 38, 115, 189, 186, 139, 
		85, 80, 74, 171, 181, 165, 98, 54, 122, 
		190, 179, 119, 79, 109, 137, 92, 89, 120, 
		230, 197, 133, 79, 51, 73, 132, 229, 171, 
		114, 36, 68, 197, 209, 156, 46, 69, 130, 
		158, 174, 156, 138, 102, 43, 83, 148, 149, 
		179, 197, 161, 64, 45, 74, 165, 213, 142, 
		87, 93, 120, 139, 154, 158, 133, 95, 88, 
		111, 165, 169, 130, 102, 109, 97, 114, 142, 
		161, 172, 127, 111, 98, 114, 107, 124, 164, 
		133, 124, 93, 141, 162, 145, 116, 101, 124, 
		100, 119, 133, 172, 164, 112, 90, 99, 130, 
		124, 144, 173, 136, 104, 99, 115, 119, 131, 
		139, 148, 139, 106, 130, 131, 124, 115, 117, 
		140, 142, 125, 120, 123, 138, 127, 109, 114, 
		137, 161, 138, 116, 111, 113, 114, 125, 146, 
		137, 131, 127, 128, 127, 124, 120, 113, 129, 
		136, 138, 131, 128, 119, 121, 121, 129, 132, 
		123, 134, 134, 132, 123, 125, 120, 124, 125, 
		126, 132, 130, 133, 134, 129, 118, 123, 122, 
		121, 132, 136, 124, 119, 130, 134, 131, 119, 
		130, 133, 123, 123, 127, 126, 119, 132, 133, 
		133, 129, 129, 116, 125, 138, 120, 124, 129, 
		138, 126, 119, 127, 132, 130, 115, 130, 142, 
		125, 120, 129, 126, 126, 126, 128, 139, 123, 
		118, 114, 129, 137, 134, 139, 132, 125, 116, 
		113, 112, 128, 146, 137, 127, 128, 117, 126, 
		130, 124, 130, 127, 122, 130, 122, 138, 127, 
		104, 125, 147, 146, 125, 105, 131, 132, 105, 
		124, 136, 148, 128, 122, 114, 107, 129, 149, 
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
};const Xasin::Audio::bytecassette_data_t cassette_clickl_4 = XASAUDIO_CASSETTE(raw_audio_array_clickl_4, 24000, 20);
