Xasin/TapBadgeV2/(commit log)

2021-07-29 First proper commit of Tap's schematic!
    [ESP_Core.sch, LSM6DSMTR--3DModel-STEP-56544.STEP, OLED_Panel.sch, Power.sch, RingOfLED.sch, Sensors.sch, TapBadgeV2-B.Cu.dxf, TapBadgeV2-B.Mask.dxf]
2021-08-01 Continue work on Schematics
    [ESP_Core.sch, OLED_Panel.sch, Power.sch, Reset.sch, RingOfLED.sch, Sensors.sch, TapBadgeV2.kicad_pcb, TapBadgeV2.sch]
2021-08-30 Add STM32 base circuit for power control and USB, also a lot of other things
    [ESP_Core.sch, OLED_Panel.sch, Power.sch, RingOfLED.sch, Sensors.sch, TapBadgeV2.kicad_pcb, TapBadgeV2.sch]
2021-08-30 Add STM32 workspace
2021-09-08 Continue work on TapV2's schematic, almost completing it!
    [ESP_Core.sch, OLED_Panel.sch, Power.sch, RingOfLED.sch, Sensors.sch, TapBadgeV2.csv, TapBadgeV2.kicad_pcb, TapBadgeV2.sch]
2021-09-28 Finalize PCB schematics
    [ESP_Core.sch, Power.sch, RingOfLED.sch, Sensors.sch, TapBadgeV2.kicad_pcb, TapBadgeV2.sch]
2021-10-18 Continue monch-work
    [TapBadgeV2.kicad_pcb]
